RiQ4/Eric_Pina_Electiva_2025_C2/Diseños/Garabato.jpg

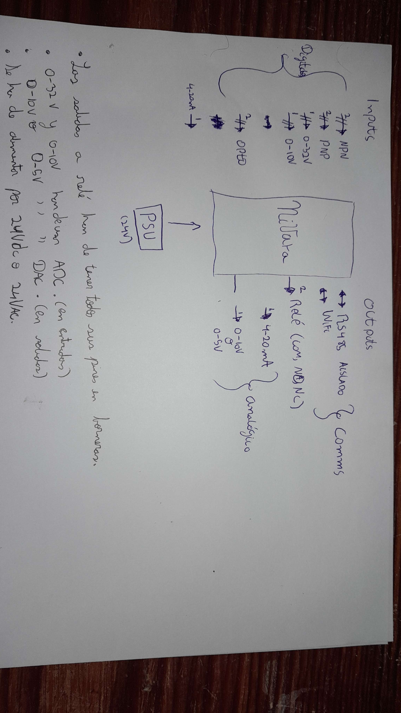
Diseños/Garabato.jpg
