RiQ4/Eric_Pina_Electiva_2025_C2/Documentos/Resumenes_Investigaciones/Eric Piña - MBSE.pdf

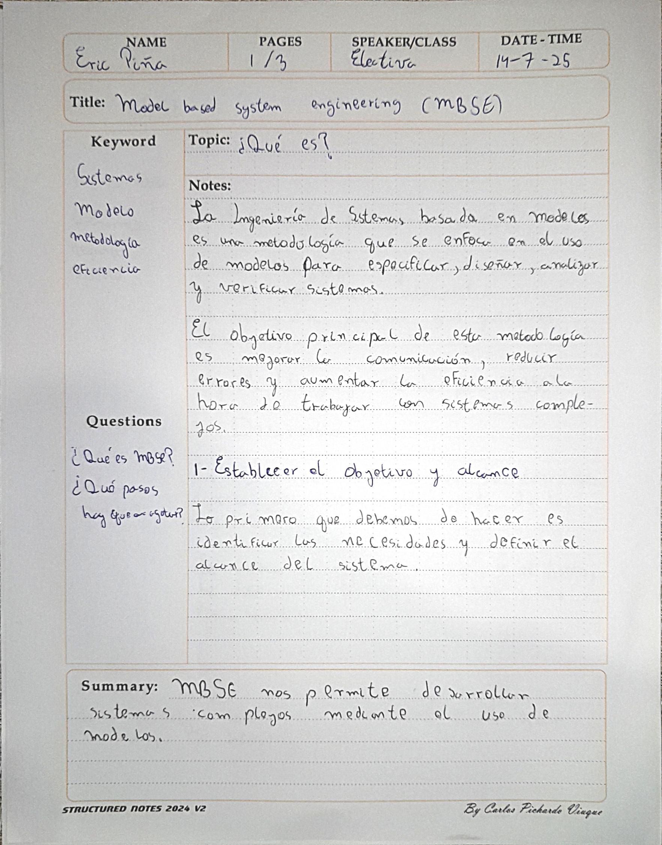
[picture p2: page 1]
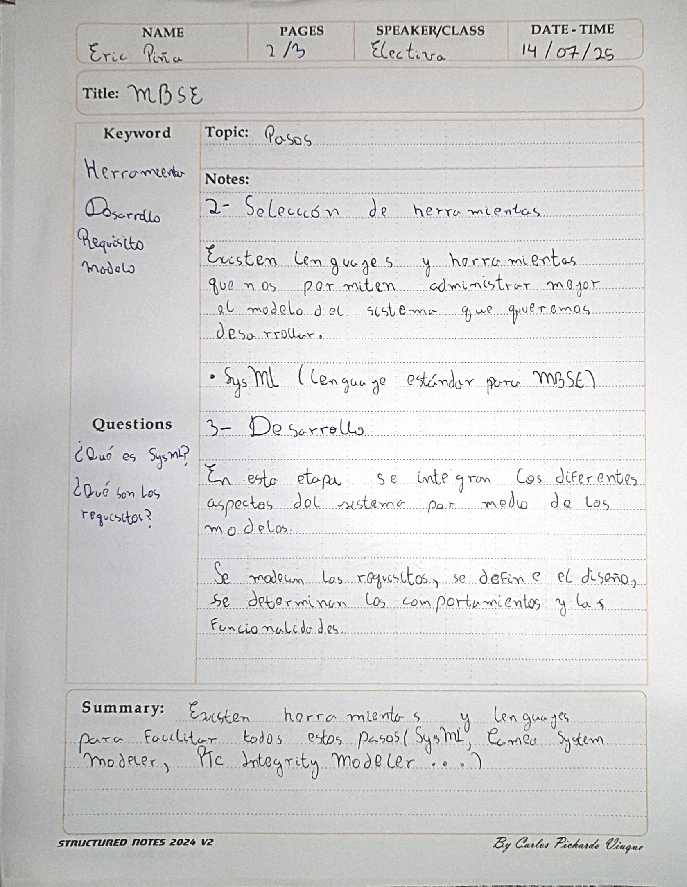
[picture p3: page 2]
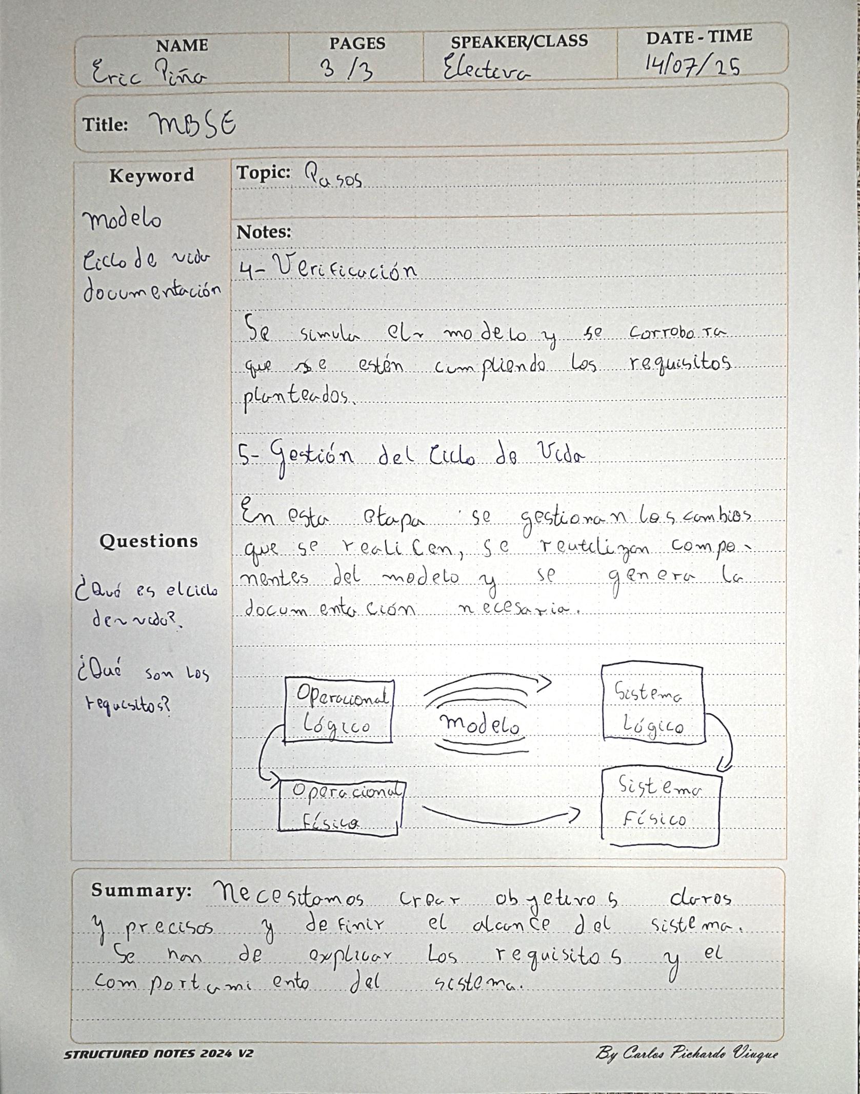
[picture p4: page 3]
