RiQ4/Eric_Pina_Electiva_2025_C2/Documentos/Resumenes_Investigaciones/Eric Piña - Lazo de Corriente.pdf

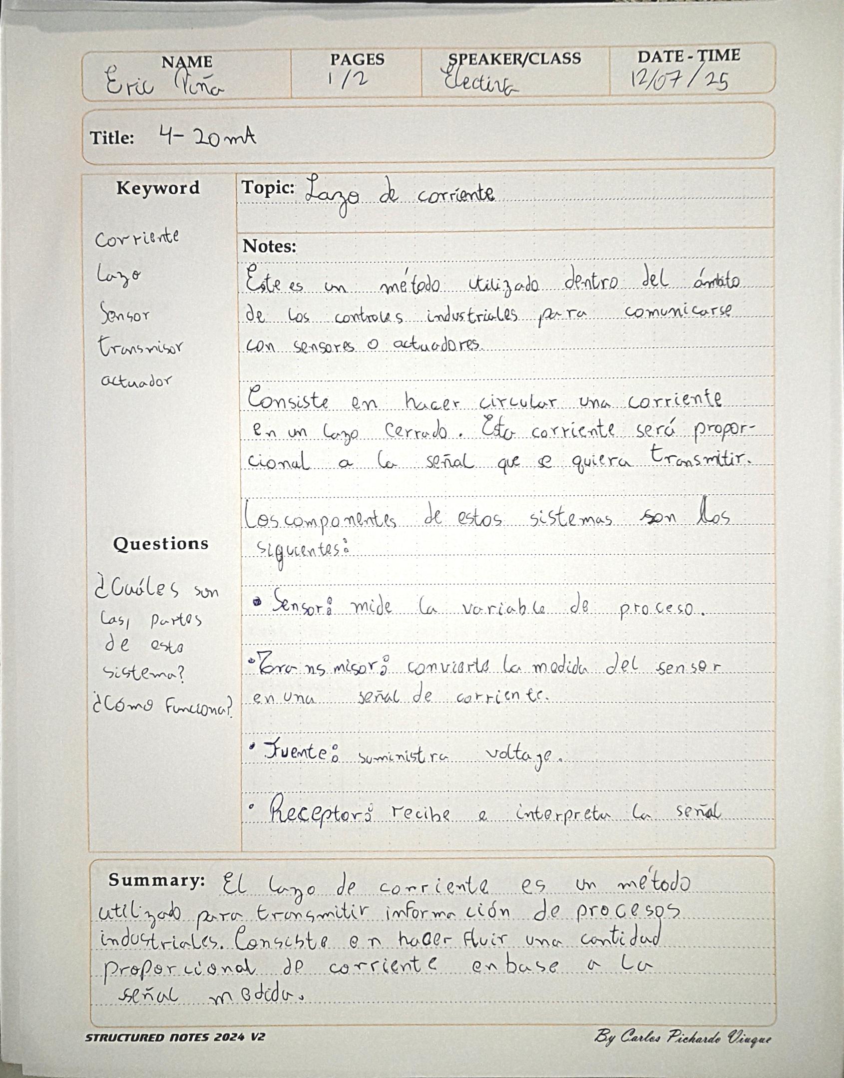
[picture p5: page 1]
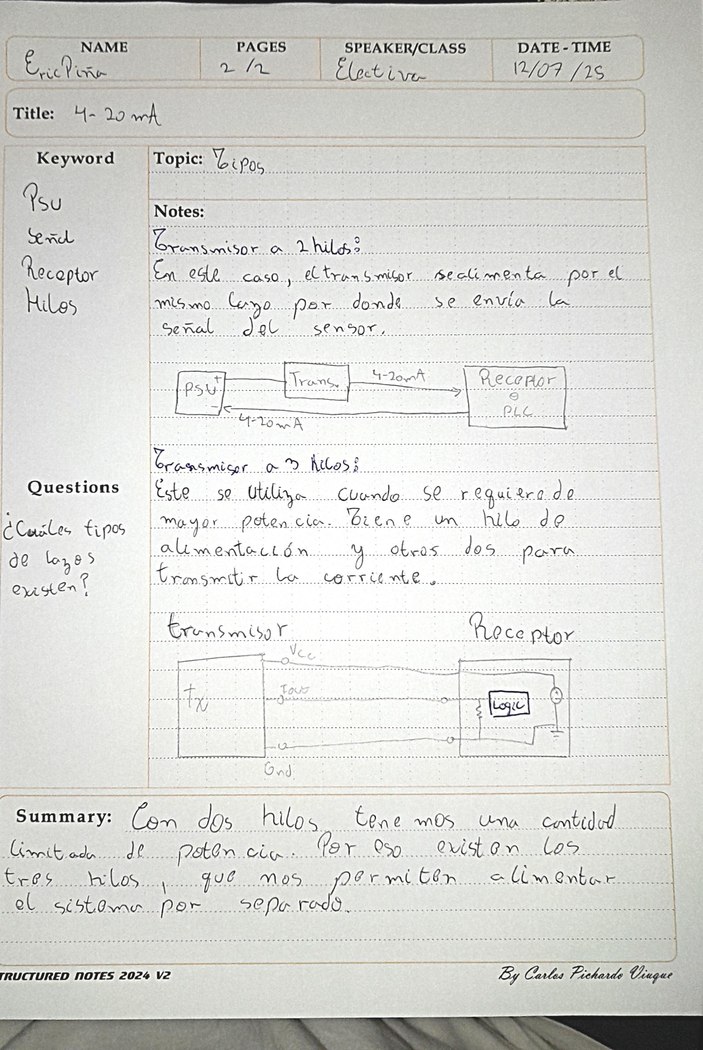
[picture p6: page 2]
