RiQ4/Eric_Pina_Electiva_2025_C2/Diseños/Piezas/FreeCAD/Tapa.FCStd

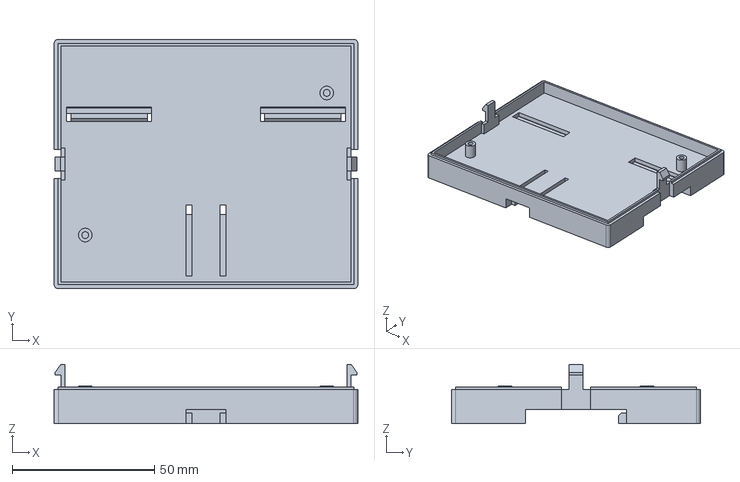
[picture p7: CAD file, 2025-06-05]
Diseños/Piezas/FreeCAD/Tapa.FCStd
107.0 x 87.7 x 20.8 mm
