RiQ4/Eric_Pina_Electiva_2025_C2/Diseños/Piezas/FreeCAD/Cuerpo.FCStd

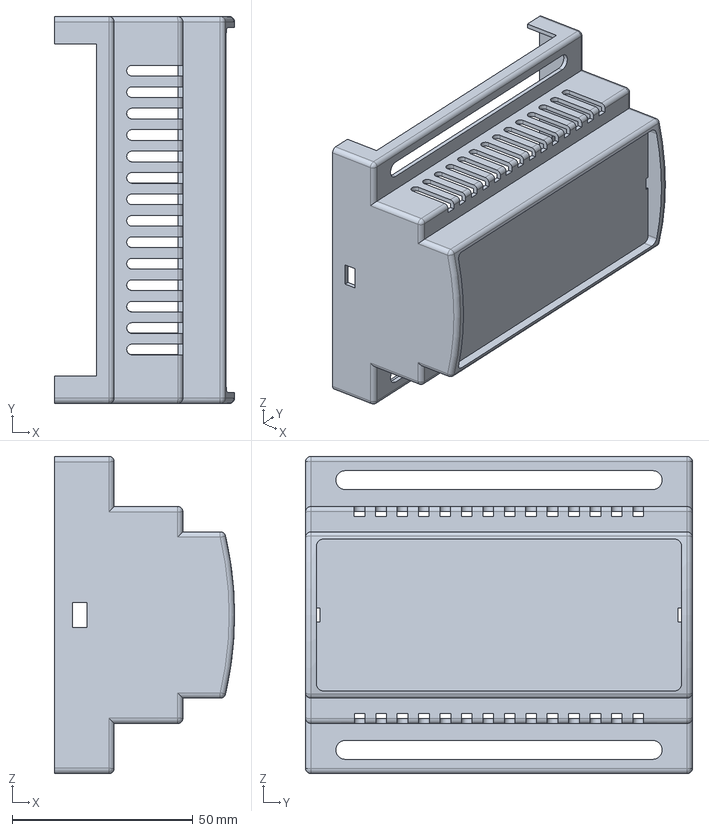
[picture p8: CAD file, 2025-06-05]
Diseños/Piezas/FreeCAD/Cuerpo.FCStd
49.8 x 107.0 x 87.7 mm
