RiQ4/Eric_Pina_Electiva_2025_C2/Kicad/NIVARA/NIVARA.kicad_pcb

## KiCad design Kicad/NIVARA/NIVARA.kicad_pcb (2025-08-22)

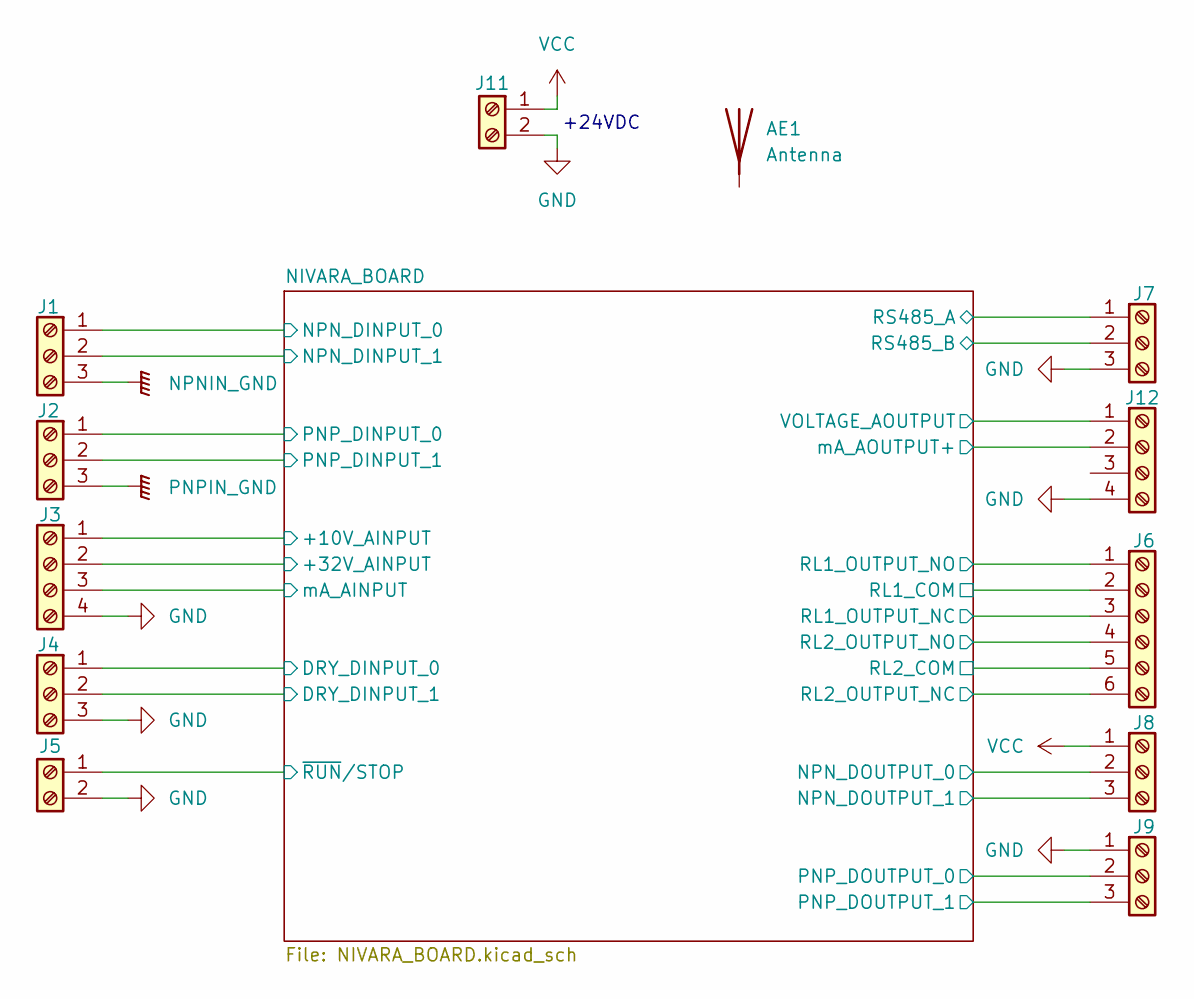
[picture p9: schematic NIVARA.kicad_sch]

Parts:
AE1: Antenna
J1, J2, J4, J7, J8, J9: Screw_Terminal_01x03; TerminalBlock_4Ucon_1x03_P3.50mm_Horizontal
J3, J12: Screw_Terminal_01x04; TerminalBlock_4Ucon_1x04_P3.50mm_Horizontal
J5, J11: Screw_Terminal_01x02; TerminalBlock_4Ucon_1x02_P3.50mm_Horizontal
J6: Screw_Terminal_01x06; TerminalBlock_4Ucon_1x06_P3.50mm_Horizontal

Connections:
/NIVARA_BOARD/+10V_AINPUT: J3.1; also elsewhere on the board
/NIVARA_BOARD/+32V_AINPUT: J3.2; also elsewhere on the board
/NIVARA_BOARD/DRY_DINPUT_0: J4.1; also elsewhere on the board
/NIVARA_BOARD/DRY_DINPUT_1: J4.2; also elsewhere on the board
/NIVARA_BOARD/NPN_DINPUT_0: J1.1; also elsewhere on the board
/NIVARA_BOARD/NPN_DINPUT_1: J1.2; also elsewhere on the board
/NIVARA_BOARD/NPN_DOUTPUT_0: J8.2; also elsewhere on the board
/NIVARA_BOARD/NPN_DOUTPUT_1: J8.3; also elsewhere on the board
/NIVARA_BOARD/PNP_DINPUT_0: J2.1; also elsewhere on the board
/NIVARA_BOARD/PNP_DINPUT_1: J2.2; also elsewhere on the board
/NIVARA_BOARD/PNP_DOUTPUT_0: J9.2; also elsewhere on the board
/NIVARA_BOARD/PNP_DOUTPUT_1: J9.3; also elsewhere on the board
/NIVARA_BOARD/RL1_COM: J6.2; also elsewhere on the board
/NIVARA_BOARD/RL1_OUTPUT_NC: J6.3; also elsewhere on the board
/NIVARA_BOARD/RL1_OUTPUT_NO: J6.1; also elsewhere on the board
/NIVARA_BOARD/RL2_COM: J6.5; also elsewhere on the board
/NIVARA_BOARD/RL2_OUTPUT_NC: J6.6; also elsewhere on the board
/NIVARA_BOARD/RL2_OUTPUT_NO: J6.4; also elsewhere on the board
/NIVARA_BOARD/RS485_A: J7.1; also elsewhere on the board
/NIVARA_BOARD/RS485_B: J7.2; also elsewhere on the board
/NIVARA_BOARD/VOLTAGE_AOUTPUT: J12.1; also elsewhere on the board
/NIVARA_BOARD/mA_AINPUT: J3.3; also elsewhere on the board
/NIVARA_BOARD/mA_AOUTPUT+: J12.2; also elsewhere on the board
/NIVARA_BOARD/~RUN/STOP: J5.1; also elsewhere on the board
GND: J3.4, J4.3, J5.2, J7.3, J9.1, J11.2, J12.4; also elsewhere on the board
NPNIN_GND: J1.3; also elsewhere on the board
PNPIN_GND: J2.3; also elsewhere on the board
VCC: J8.1, J11.1; also elsewhere on the board

Notes on the sheet:
+24VDC

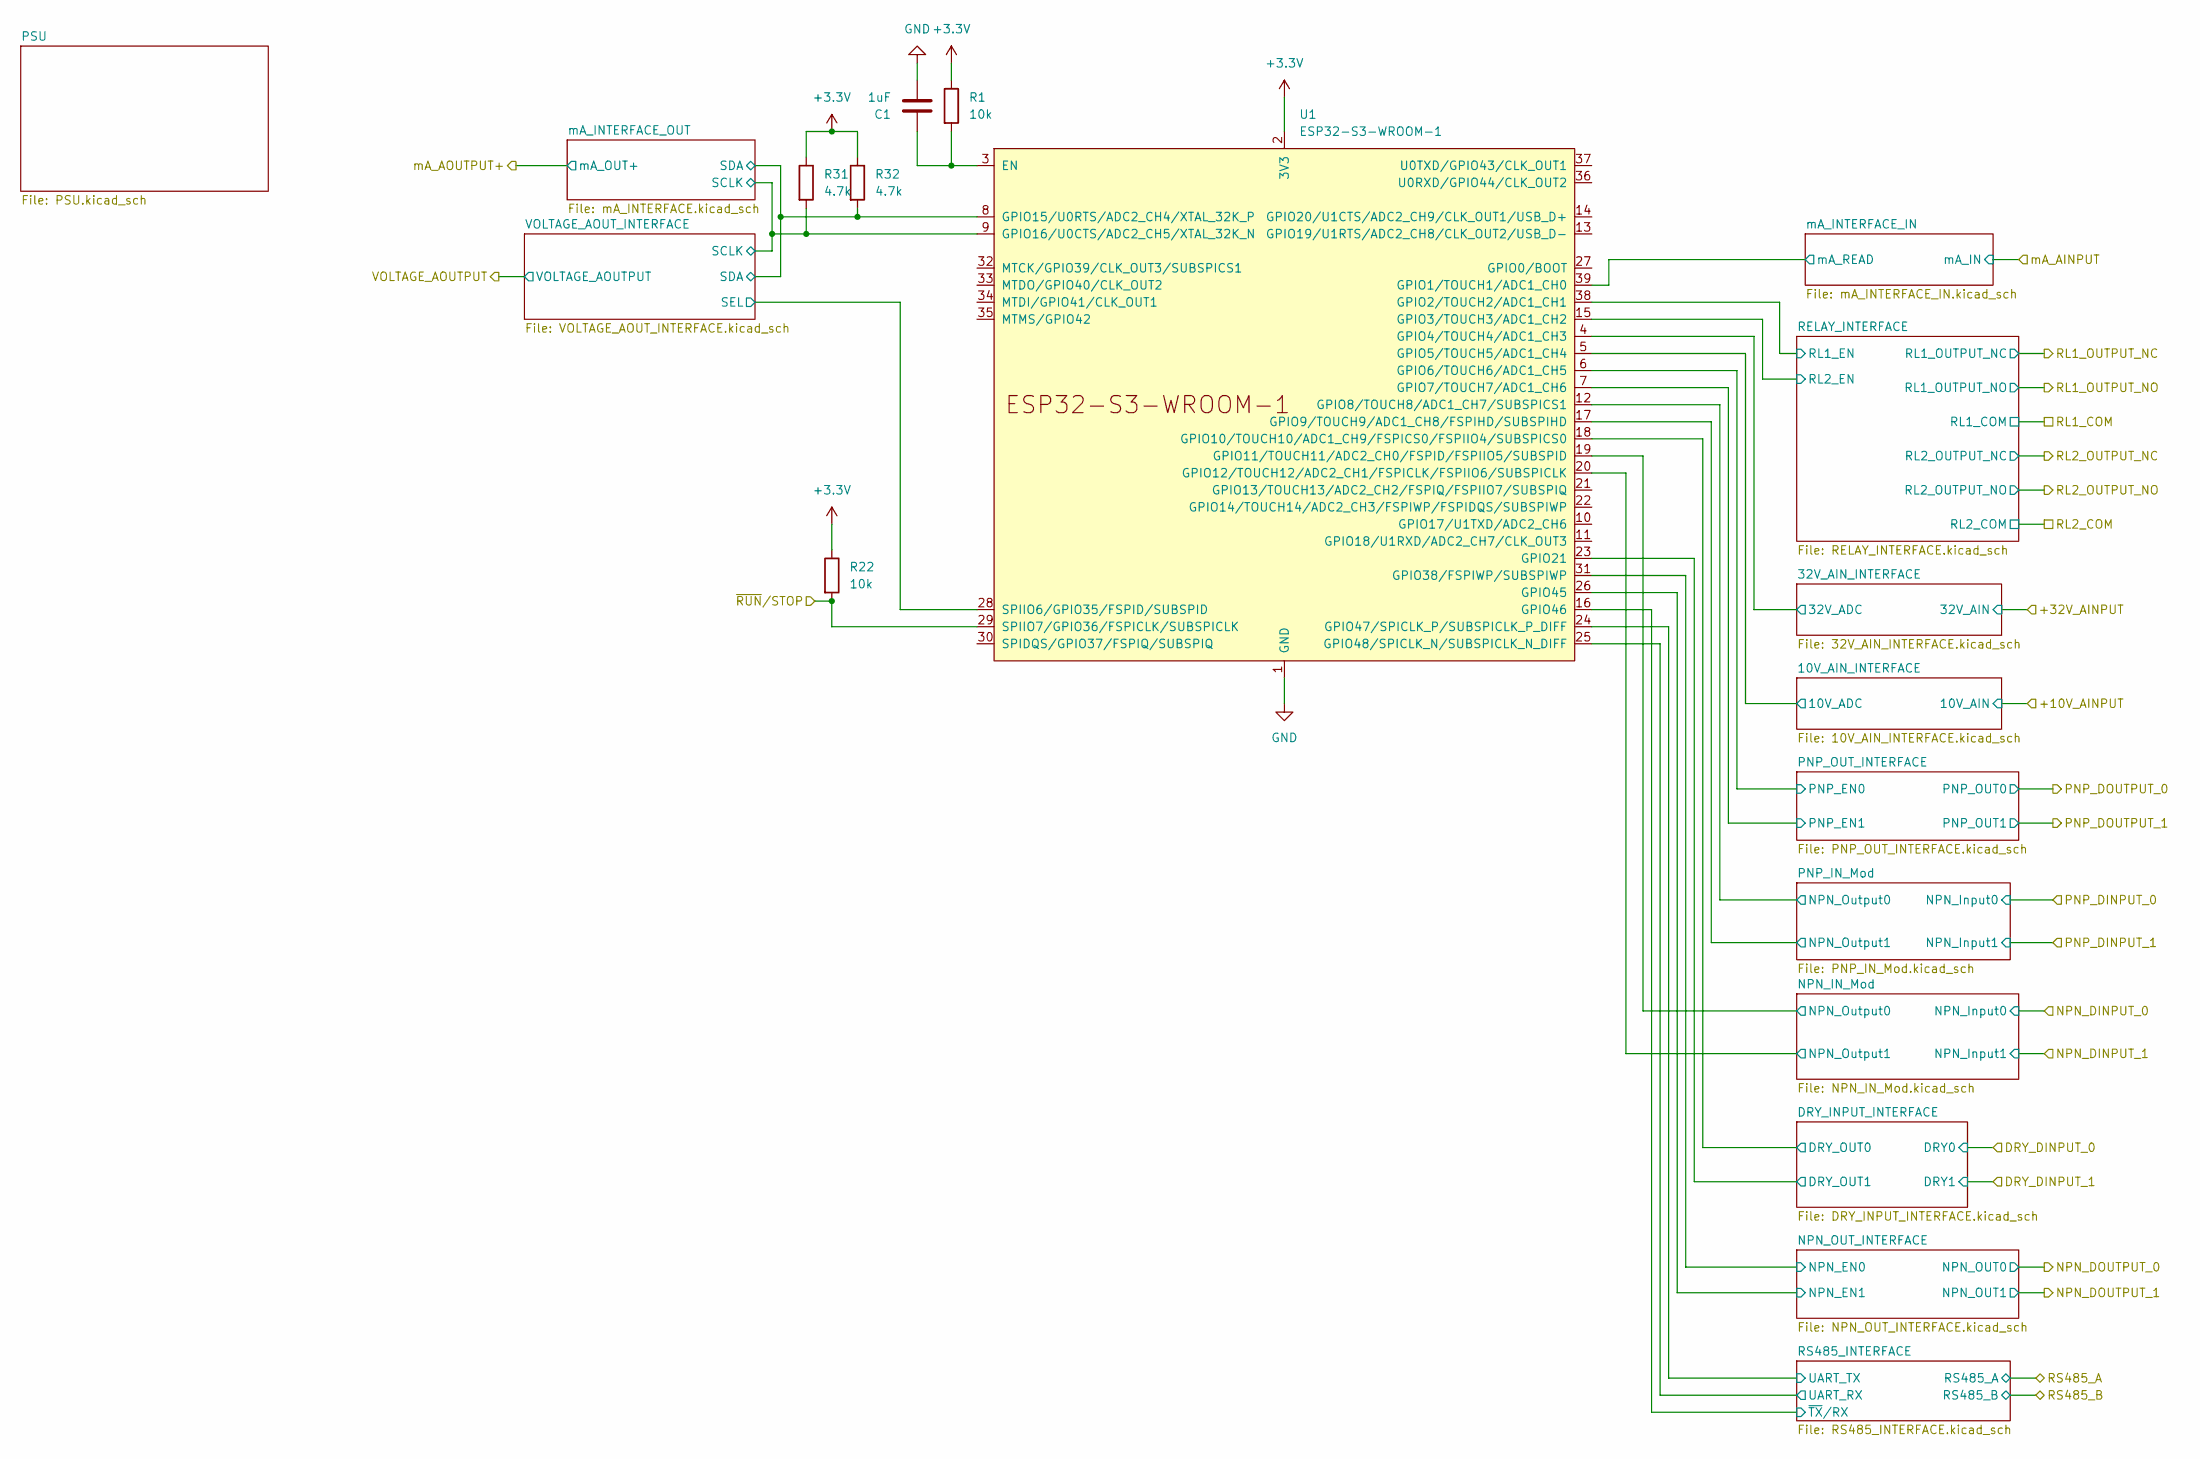
[picture p10: schematic NIVARA_BOARD.kicad_sch, NIVARA]

Parts:
C1: 1uF; C_0603_1608Metric
R1, R22: 10k; R_0603_1608Metric
R31, R32: 4.7k; R_0603_1608Metric
U1: ESP32-S3-WROOM-1

Connections:
+3.3V: R1.1, R22.1, R31.1, R32.1, U1.2 (3V3); also elsewhere on the board
/NIVARA_BOARD/10V_AIN_INTERFACE/10V_ADC: U1.5 (GPIO5/TOUCH5/ADC1_CH4); also elsewhere on the board
/NIVARA_BOARD/32V_AIN_INTERFACE/32V_ADC: U1.4 (GPIO4/TOUCH4/ADC1_CH3); also elsewhere on the board
/NIVARA_BOARD/DRY_INPUT_INTERFACE/DRY_OUT0: U1.18 (GPIO10/TOUCH10/ADC1_CH9/FSPICS0/FSPIIO4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); also elsewhere on the board
/NIVARA_BOARD/DRY_INPUT_INTERFACE/DRY_OUT1: U1.23 (GPIO21); also elsewhere on the board
/NIVARA_BOARD/NPN_IN_Mod/NPN_Output0: U1.19 (GPIO11/TOUCH11/ADC2_CH0/FSPID/FSPIIO5/S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); also elsewhere on the board
/NIVARA_BOARD/NPN_IN_Mod/NPN_Output1: U1.20 (GPIO12/TOUCH12/ADC2_CH1/FSPICLK/FSPIIO6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); also elsewhere on the board
/NIVARA_BOARD/NPN_OUT_INTERFACE/NPN_EN0: U1.31 (GPIO38/FSPIWP/SUBSPIWP); also elsewhere on the board
/NIVARA_BOARD/NPN_OUT_INTERFACE/NPN_EN1: U1.26 (GPIO45); also elsewhere on the board
/NIVARA_BOARD/PNP_IN_Mod/NPN_Output0: U1.12 (GPIO8/TOUCH8/ADC1_CH7/SUBSPICS1); also elsewhere on the board
/NIVARA_BOARD/PNP_IN_Mod/NPN_Output1: U1.17 (GPIO9/TOUCH9/ADC1_CH8/FSPIHD/SUBSPIHD); also elsewhere on the board
/NIVARA_BOARD/PNP_OUT_INTERFACE/PNP_EN0: U1.6 (GPIO6/TOUCH6/ADC1_CH5); also elsewhere on the board
/NIVARA_BOARD/PNP_OUT_INTERFACE/PNP_EN1: U1.7 (GPIO7/TOUCH7/ADC1_CH6); also elsewhere on the board
/NIVARA_BOARD/RELAY_INTERFACE/RL1_EN: U1.38 (GPIO2/TOUCH2/ADC1_CH1); also elsewhere on the board
/NIVARA_BOARD/RELAY_INTERFACE/RL2_EN: U1.15 (GPIO3/TOUCH3/ADC1_CH2); also elsewhere on the board
/NIVARA_BOARD/RS485_INTERFACE/UART_RX: U1.25 (GPIO48/SPICLK_N/SUBSPICLK_N_DIFF); also elsewhere on the board
/NIVARA_BOARD/RS485_INTERFACE/UART_TX: U1.24 (GPIO47/SPICLK_P/SUBSPICLK_P_DIFF); also elsewhere on the board
/NIVARA_BOARD/RS485_INTERFACE/~TX/RX: U1.16 (GPIO46); also elsewhere on the board
/NIVARA_BOARD/VOLTAGE_AOUT_INTERFACE/SCLK: R31.2, U1.9 (GPIO16/U0CTS/ADC2_CH5/XTAL_32K_N); also elsewhere on the board
/NIVARA_BOARD/VOLTAGE_AOUT_INTERFACE/SDA: R32.2, U1.8 (GPIO15/U0RTS/ADC2_CH4/XTAL_32K_P); also elsewhere on the board
/NIVARA_BOARD/VOLTAGE_AOUT_INTERFACE/SEL: U1.28 (SPIIO6/GPIO35/FSPID/SUBSPID); also elsewhere on the board
/NIVARA_BOARD/mA_AINPUT: U1.39 (GPIO1/TOUCH1/ADC1_CH0); also elsewhere on the board
/NIVARA_BOARD/~RUN/STOP: R22.2, U1.29 (SPIIO7/GPIO36/FSPICLK/SUBSPICLK); also elsewhere on the board
GND: C1.2, U1.1 (GND), U1.40 (GND), U1.41 (GND); also elsewhere on the board
unnamed: C1.1, R1.2, U1.3 (EN)

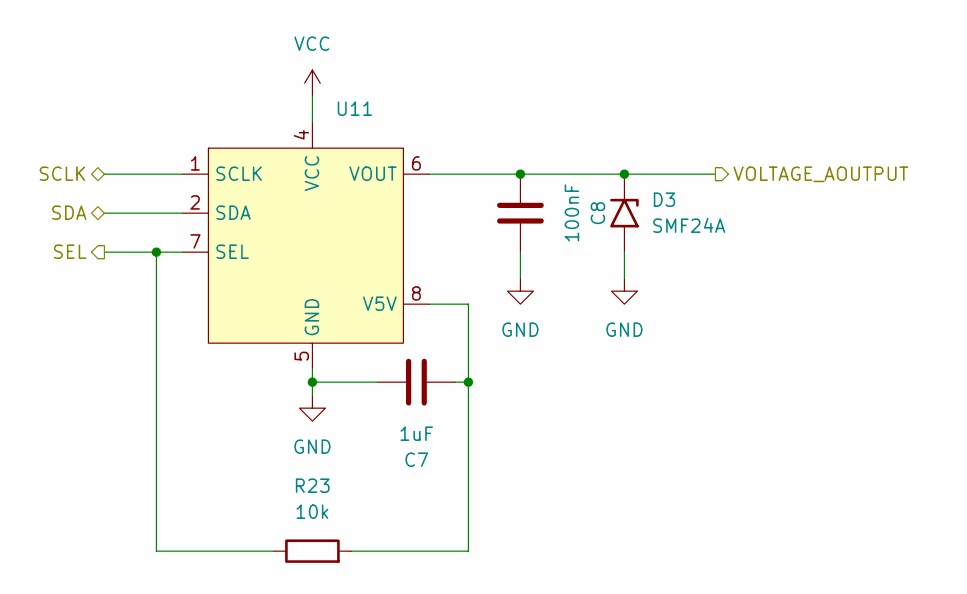
[picture p11: schematic VOLTAGE_AOUT_INTERFACE.kicad_sch]

Parts:
C7: 1uF; C_0603_1608Metric
C8: 100nF; C_0603_1608Metric
D3: SMF24A; D_SMF; LCSC# C7495269
R23: 10k; R_0603_1608Metric
U11: eSOP-8

Connections:
/NIVARA_BOARD/VOLTAGE_AOUTPUT: C8.2, D3.1 (A1), U11.6 (VOUT); also elsewhere on the board
/NIVARA_BOARD/VOLTAGE_AOUT_INTERFACE/SCLK: U11.1 (SCLK); also elsewhere on the board
/NIVARA_BOARD/VOLTAGE_AOUT_INTERFACE/SDA: U11.2 (SDA); also elsewhere on the board
/NIVARA_BOARD/VOLTAGE_AOUT_INTERFACE/SEL: R23.1, U11.7 (SEL); also elsewhere on the board
GND: C7.1, C8.1, D3.2 (A2), U11.5 (GND); also elsewhere on the board
unnamed: C7.2, R23.2, U11.8 (V5V)
VCC: U11.4 (VCC); also elsewhere on the board

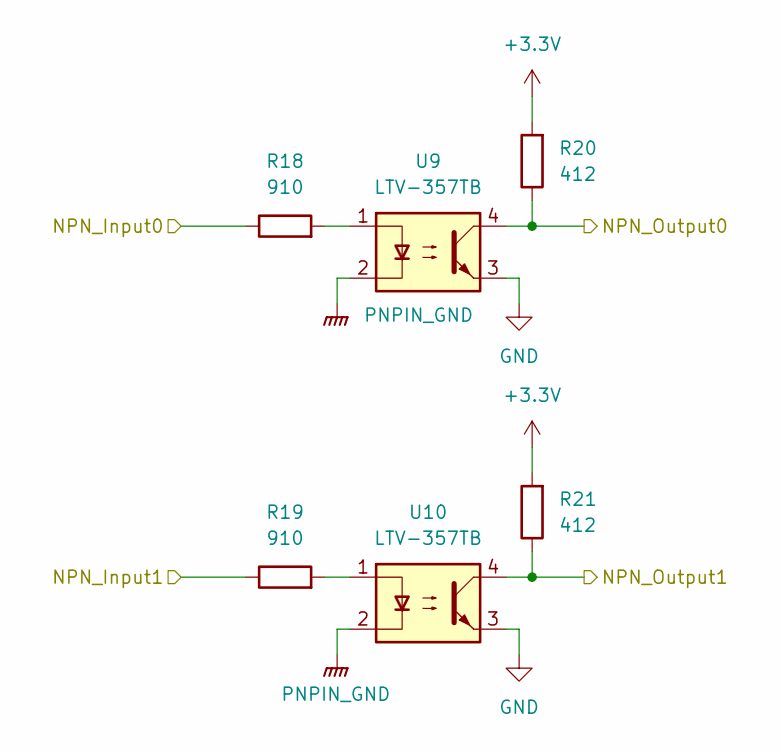
[picture p12: schematic PNP_IN_Mod.kicad_sch]

Parts:
R18, R19: 910; R_0603_1608Metric; LCSC# C114670
R20, R21: 412; R_0603_1608Metric
U9, U10: LTV-357TB; SO-4_4.4x3.6mm_P2.54mm

Connections:
+3.3V: R20.2, R21.2; also elsewhere on the board
/NIVARA_BOARD/PNP_DINPUT_0: R18.1; also elsewhere on the board
/NIVARA_BOARD/PNP_DINPUT_1: R19.1; also elsewhere on the board
/NIVARA_BOARD/PNP_IN_Mod/NPN_Output0: R20.1, U9.4; also elsewhere on the board
/NIVARA_BOARD/PNP_IN_Mod/NPN_Output1: R21.1, U10.4; also elsewhere on the board
GND: U9.3, U10.3; also elsewhere on the board
unnamed: R18.2, U9.1
unnamed: R19.2, U10.1
PNPIN_GND: U9.2, U10.2; also elsewhere on the board

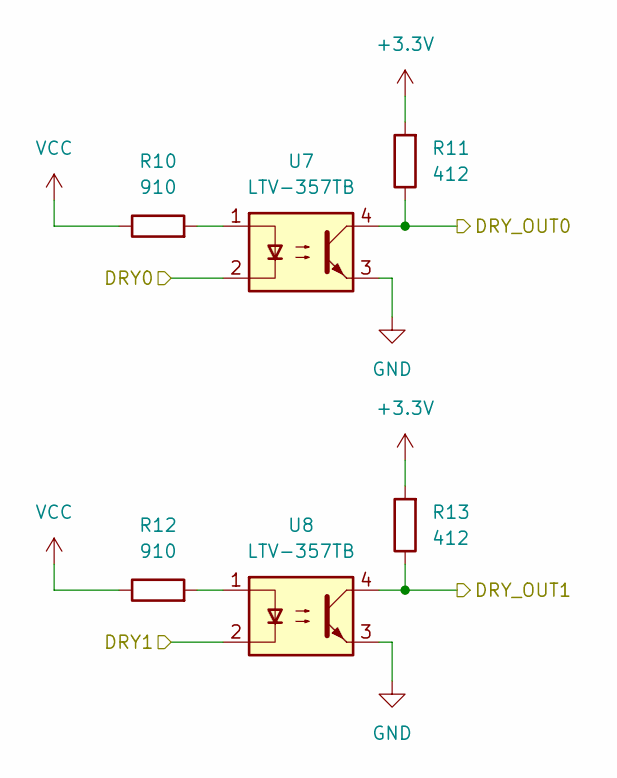
[picture p13: schematic DRY_INPUT_INTERFACE.kicad_sch]

Parts:
R10, R12: 910; R_0603_1608Metric; LCSC# C114670
R11, R13: 412; R_0603_1608Metric
U7, U8: LTV-357TB; SO-4_4.4x3.6mm_P2.54mm

Connections:
+3.3V: R11.2, R13.2; also elsewhere on the board
/NIVARA_BOARD/DRY_DINPUT_0: U7.2; also elsewhere on the board
/NIVARA_BOARD/DRY_DINPUT_1: U8.2; also elsewhere on the board
/NIVARA_BOARD/DRY_INPUT_INTERFACE/DRY_OUT0: R11.1, U7.4; also elsewhere on the board
/NIVARA_BOARD/DRY_INPUT_INTERFACE/DRY_OUT1: R13.1, U8.4; also elsewhere on the board
GND: U7.3, U8.3; also elsewhere on the board
unnamed: R10.2, U7.1
unnamed: R12.2, U8.1
VCC: R10.1, R12.1; also elsewhere on the board

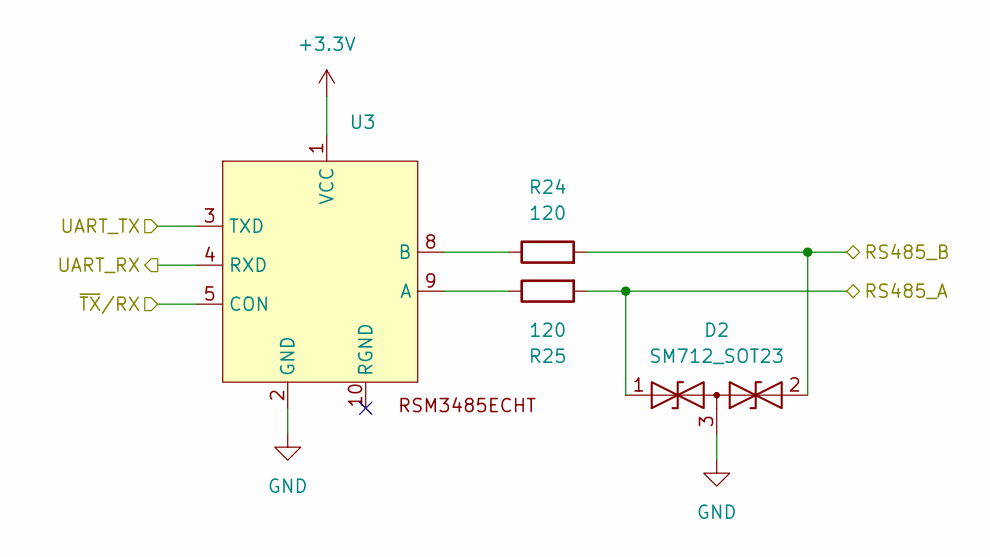
[picture p14: schematic RS485_INTERFACE.kicad_sch]

Parts:
D2: SM712_SOT23; SOT-23
R24, R25: 120; R_0603_1608Metric
U3: YLPTEC RSM3485ECHT

Connections:
+3.3V: U3.1 (VCC); also elsewhere on the board
/NIVARA_BOARD/RS485_A: D2.1 (A1), R25.2; also elsewhere on the board
/NIVARA_BOARD/RS485_B: D2.2 (A2), R24.2; also elsewhere on the board
/NIVARA_BOARD/RS485_INTERFACE/UART_RX: U3.4 (RXD); also elsewhere on the board
/NIVARA_BOARD/RS485_INTERFACE/UART_TX: U3.3 (TXD); also elsewhere on the board
/NIVARA_BOARD/RS485_INTERFACE/~TX/RX: U3.5 (CON); also elsewhere on the board
GND: D2.3 (common), U3.2 (GND); also elsewhere on the board
unnamed: R25.1, U3.9 (A)
unnamed: R24.1, U3.8 (B)

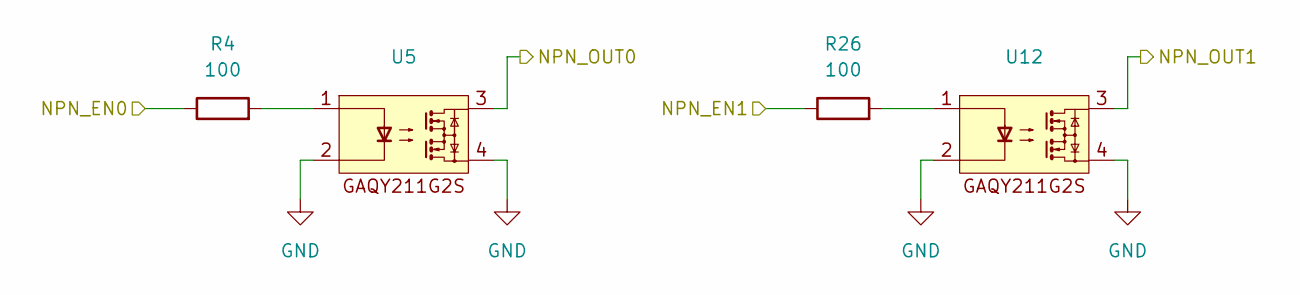
[picture p15: schematic NPN_OUT_INTERFACE.kicad_sch]

Parts:
R4, R26: 100; R_0603_1608Metric
U5, U12: SO-4_4.4x4.3mm_P2.54mm

Connections:
/NIVARA_BOARD/NPN_DOUTPUT_0: U5.3; also elsewhere on the board
/NIVARA_BOARD/NPN_DOUTPUT_1: U12.3; also elsewhere on the board
/NIVARA_BOARD/NPN_OUT_INTERFACE/NPN_EN0: R4.1; also elsewhere on the board
/NIVARA_BOARD/NPN_OUT_INTERFACE/NPN_EN1: R26.1; also elsewhere on the board
GND: U5.2, U5.4, U12.2, U12.4; also elsewhere on the board
unnamed: R4.2, U5.1
unnamed: R26.2, U12.1

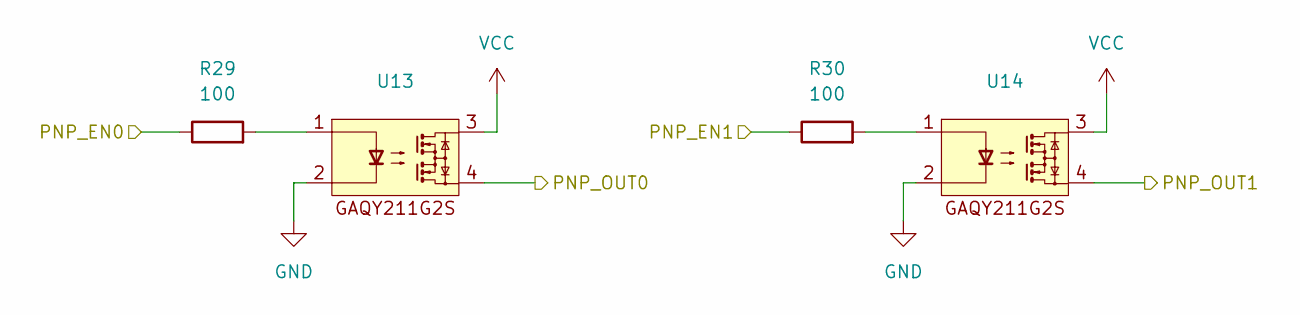
[picture p16: schematic PNP_OUT_INTERFACE.kicad_sch]

Parts:
R29, R30: 100; R_0603_1608Metric
U13, U14: SO-4_4.4x4.3mm_P2.54mm

Connections:
/NIVARA_BOARD/PNP_DOUTPUT_0: U13.4; also elsewhere on the board
/NIVARA_BOARD/PNP_DOUTPUT_1: U14.4; also elsewhere on the board
/NIVARA_BOARD/PNP_OUT_INTERFACE/PNP_EN0: R29.1; also elsewhere on the board
/NIVARA_BOARD/PNP_OUT_INTERFACE/PNP_EN1: R30.1; also elsewhere on the board
GND: U13.2, U14.2; also elsewhere on the board
unnamed: R29.2, U13.1
unnamed: R30.2, U14.1
VCC: U13.3, U14.3; also elsewhere on the board

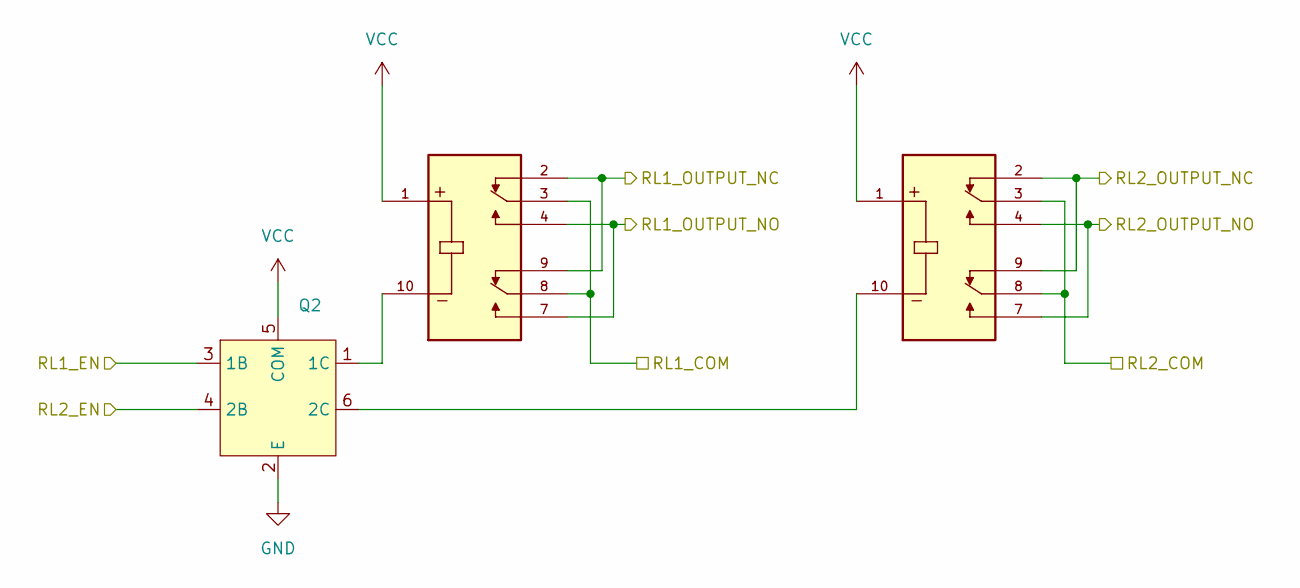
[picture p17: schematic RELAY_INTERFACE.kicad_sch]

Parts:
K1, K2: TQ2-24V; TQ2=24V; PARTREV 201911
Q2: SOT-363_SC-70-6; LCSC# C2984831

Connections:
/NIVARA_BOARD/RELAY_INTERFACE/RL1_EN: Q2.3 (1B); also elsewhere on the board
/NIVARA_BOARD/RELAY_INTERFACE/RL2_EN: Q2.4 (2B); also elsewhere on the board
/NIVARA_BOARD/RL1_COM: K1.3, K1.8; also elsewhere on the board
/NIVARA_BOARD/RL1_OUTPUT_NC: K1.2, K1.9; also elsewhere on the board
/NIVARA_BOARD/RL1_OUTPUT_NO: K1.4, K1.7; also elsewhere on the board
/NIVARA_BOARD/RL2_COM: K2.3, K2.8; also elsewhere on the board
/NIVARA_BOARD/RL2_OUTPUT_NC: K2.2, K2.9; also elsewhere on the board
/NIVARA_BOARD/RL2_OUTPUT_NO: K2.4, K2.7; also elsewhere on the board
GND: Q2.2 (E); also elsewhere on the board
unnamed: K1.10, Q2.1 (1C)
unnamed: K2.10, Q2.6 (2C)
VCC: K1.1, K2.1, Q2.5 (COM); also elsewhere on the board

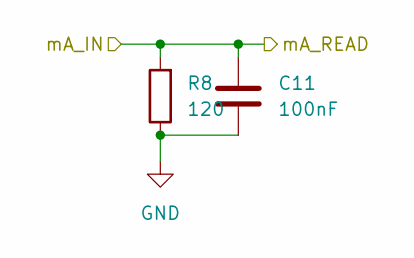
[picture p18: schematic mA_INTERFACE_IN.kicad_sch]

Parts:
C11: 100nF; C_0603_1608Metric
R8: 120; R_0603_1608Metric; Tolerance 0.1-1%

Connections:
/NIVARA_BOARD/mA_AINPUT: C11.1, R8.2; also elsewhere on the board
GND: C11.2, R8.1; also elsewhere on the board

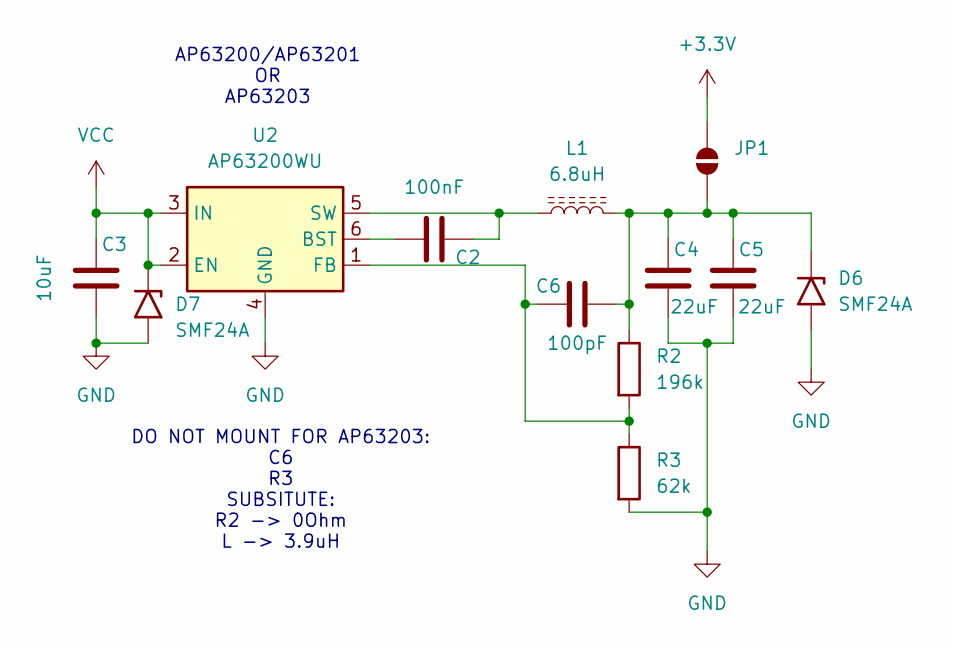
[picture p19: schematic PSU.kicad_sch]

Parts:
C2: 100nF; C_0603_1608Metric
C3: 10uF; C_0603_1608Metric; Voltage 50V
C4, C5: 22uF; C_0603_1608Metric
C6: 100pF; C_0603_1608Metric
D6, D7: SMF24A; D_SMF
JP1: SolderJumper_2_Open; SolderJumper-2_P1.3mm_Open_RoundedPad1.0x1.5mm
L1: 6.8uH; L_6.3x6.3_H3
R2: 196k; R_0603_1608Metric
R3: 62k; R_0603_1608Metric
U2: AP63200WU; TSOT-23-6

Connections:
+3.3V: JP1.2 (B); also elsewhere on the board
GND: C3.1, C4.1, C5.1, D6.2 (A2), D7.2 (A2), R3.2, U2.4 (GND); also elsewhere on the board
unnamed: C4.2, C5.2, C6.1, D6.1 (A1), JP1.1 (A), L1.2, R2.1
unnamed: C2.1, U2.6 (BST)
unnamed: C6.2, R2.2, R3.1, U2.1 (FB)
unnamed: C2.2, L1.1, U2.5 (SW)
VCC: C3.2, D7.1 (A1), U2.2 (EN), U2.3 (IN); also elsewhere on the board

Notes on the sheet:
DO NOT MOUNT FOR AP63203: C6 R3 SUBSITUTE: R2 -> 0Ohm L -> 3.9uH
AP63200/AP63201 OR AP63203

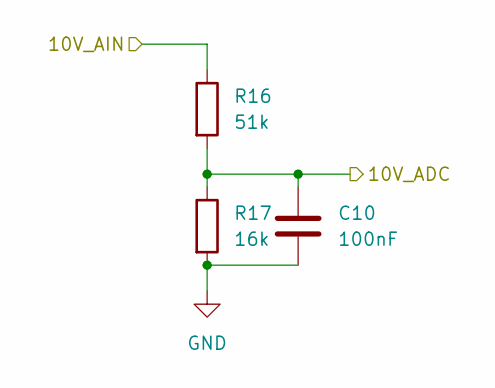
[picture p20: schematic 10V_AIN_INTERFACE.kicad_sch]

Parts:
C10: 100nF; C_0603_1608Metric
R16: 51k; R_0603_1608Metric
R17: 16k; R_0603_1608Metric

Connections:
/NIVARA_BOARD/10V_AIN_INTERFACE/10V_ADC: C10.1, R16.2, R17.1; also elsewhere on the board
/NIVARA_BOARD/+10V_AINPUT: R16.1; also elsewhere on the board
GND: C10.2, R17.2; also elsewhere on the board

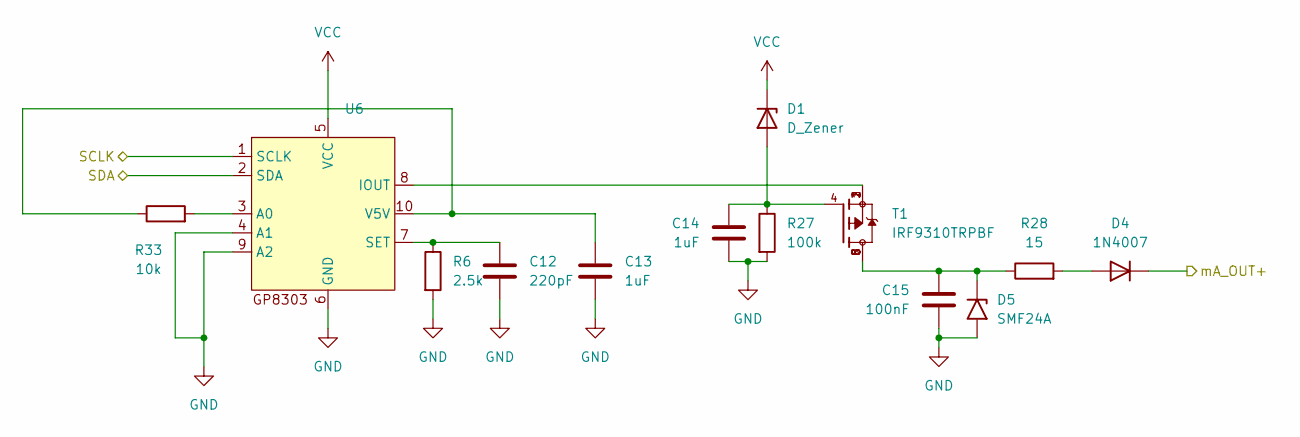
[picture p21: schematic mA_INTERFACE.kicad_sch]

Parts:
C12: 220pF; C_0603_1608Metric
C13, C14: 1uF; C_0603_1608Metric
C15: 100nF; C_0603_1608Metric
D1: D_Zener; D_SOD-123
D4: 1N4007; D_SOD-123
D5: SMF24A; D_SMF
R6: 2.5k; R_0603_1608Metric
R27: 100k; R_0603_1608Metric
R28: 15; R_0603_1608Metric
R33: 10k; R_0603_1608Metric
T1: IRF9310TRPBF; SO-8
U6: SSOP-10-1EP_3.9x4.9mm_P1mm_EP2.1x3.3mm

Connections:
/NIVARA_BOARD/VOLTAGE_AOUT_INTERFACE/SCLK: U6.1 (SCLK); also elsewhere on the board
/NIVARA_BOARD/VOLTAGE_AOUT_INTERFACE/SDA: U6.2 (SDA); also elsewhere on the board
/NIVARA_BOARD/mA_AOUTPUT+: D4.1 (K); also elsewhere on the board
GND: C12.2, C13.2, C14.2, C15.2, D5.2 (A2), R6.2, R27.2, U6.4 (A1), U6.6 (GND), U6.9 (A2); also elsewhere on the board
unnamed: C14.1, D1.2 (A), R27.1, T1.4
unnamed: D4.2 (A), R28.2
unnamed: C15.1, D5.1 (A1), R28.1, T1.5, T1.6, T1.7, T1.8
unnamed: R33.2, U6.3 (A0)
unnamed: T1.1, T1.2, T1.3, U6.8 (IOUT)
unnamed: C12.1, R6.1, U6.7 (SET)
unnamed: C13.1, R33.1, U6.10 (V5V)
VCC: D1.1 (K), U6.5 (VCC); also elsewhere on the board

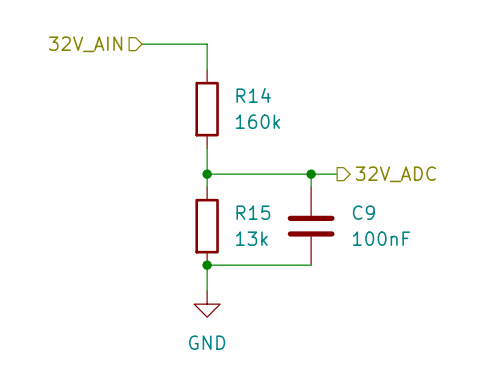
[picture p22: schematic 32V_AIN_INTERFACE.kicad_sch]

Parts:
C9: 100nF; C_0603_1608Metric
R14: 160k; R_0603_1608Metric
R15: 13k; R_0603_1608Metric

Connections:
/NIVARA_BOARD/32V_AIN_INTERFACE/32V_ADC: C9.1, R14.2, R15.1; also elsewhere on the board
/NIVARA_BOARD/+32V_AINPUT: R14.1; also elsewhere on the board
GND: C9.2, R15.2; also elsewhere on the board

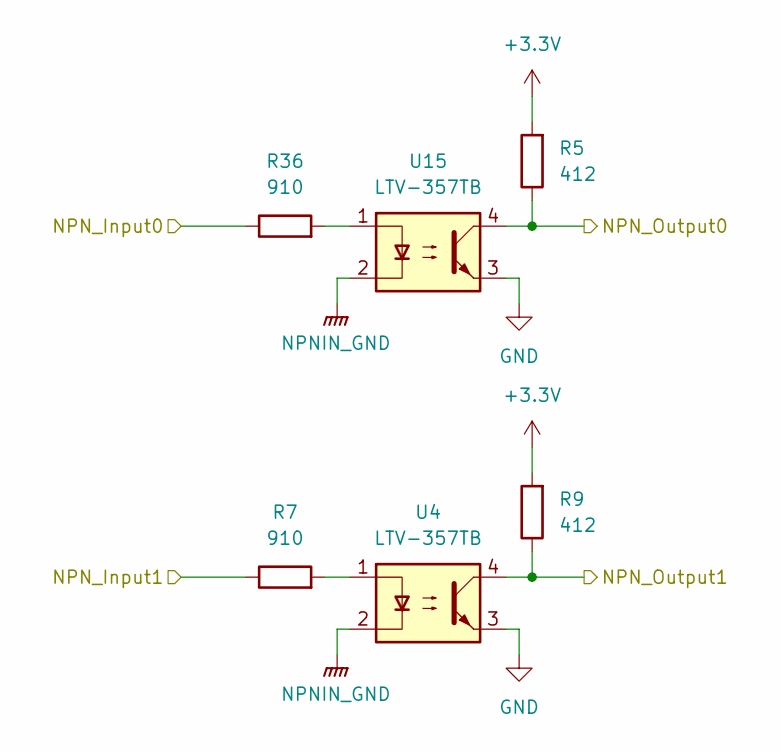
[picture p23: schematic NPN_IN_Mod.kicad_sch]

Parts:
R5, R9: 412; R_0603_1608Metric
R7, R36: 910; R_0603_1608Metric; LCSC# C114670
U4, U15: LTV-357TB; SO-4_4.4x3.6mm_P2.54mm

Connections:
+3.3V: R5.2, R9.2; also elsewhere on the board
/NIVARA_BOARD/NPN_DINPUT_0: R36.1; also elsewhere on the board
/NIVARA_BOARD/NPN_DINPUT_1: R7.1; also elsewhere on the board
/NIVARA_BOARD/NPN_IN_Mod/NPN_Output0: R5.1, U15.4; also elsewhere on the board
/NIVARA_BOARD/NPN_IN_Mod/NPN_Output1: R9.1, U4.4; also elsewhere on the board
GND: U4.3, U15.3; also elsewhere on the board
NPNIN_GND: U4.2, U15.2; also elsewhere on the board
unnamed: R7.2, U4.1
unnamed: R36.2, U15.1

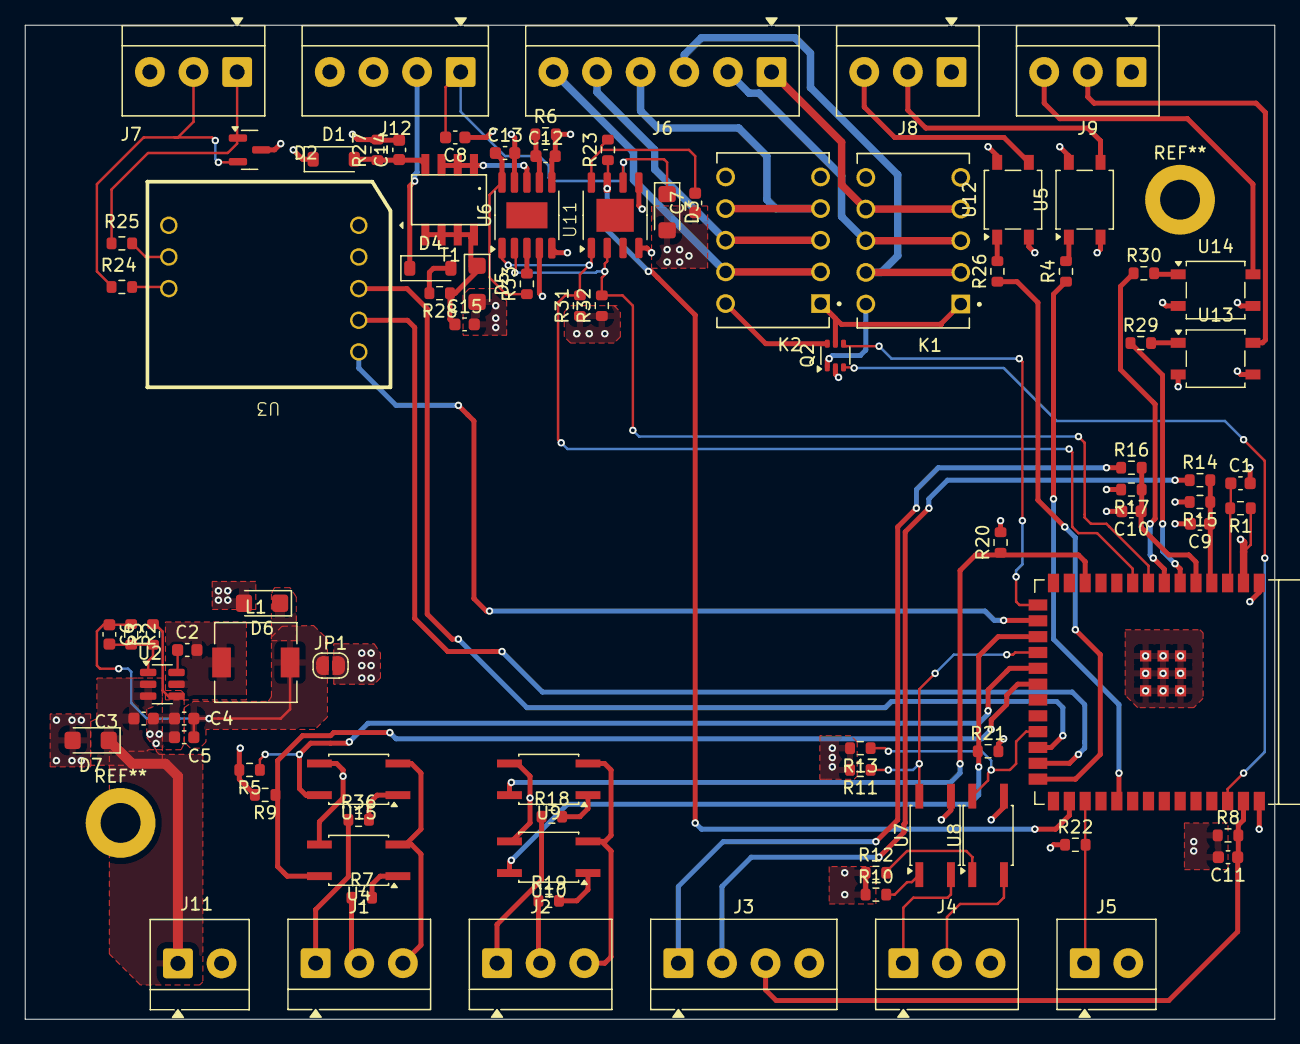
[picture p24: board NIVARA.kicad_pcb from above]

Board: 4 copper layers, 100.2 x 79.8 mm, 88 parts (0 on the bottom side), 76 nets.
