RiQ4/Eric_Pina_Electiva_2025_C2/(commit log)

2025-06-05 Diseños en programas CAD
    [Cuerpo.FCStd, Tapa.FCStd]
2025-06-13 KiCAD Files
    Creación del Proyecto en KiCAD
    [NIVARA.kicad_pcb, NIVARA.kicad_sch]
2025-06-13 Hierarchical Design In KiCAD
    [NIVARA.kicad_sch, NIVARA_BOARD.kicad_sch, PSU.kicad_sch]
2025-06-13 Hierarchical Labels added
    [NIVARA_BOARD.kicad_sch, PSU.kicad_sch]
2025-06-14 Initial Capture Finished
    [NIVARA.kicad_sch, NIVARA_BOARD.kicad_sch, PSU.kicad_sch]
2025-06-14 Wrapping up for today :3
    [NIVARA.kicad_sch, NIVARA_BOARD.kicad_sch, PSU.kicad_sch, RS485_INTERFACE.kicad_sch]
2025-06-17 Solder Jumper
    Para que no me pase lo mismo de mi proyecto
    [NIVARA.kicad_sch, PSU.kicad_sch]
2025-06-21 RS-485 Update
    RS-485 Isolated circuit updated. Created new symbol and footprint for the YLPTEC RSM3485ECHT IC.
    [NIVARA_BOARD.kicad_sch, RS485_INTERFACE.kicad_sch]
2025-06-22 Silly little things
    [RS485_INTERFACE.kicad_sch]
2025-06-23 Relay Interface
    Progress made with the Relay Interface.
    [NIVARA.kicad_pcb, NIVARA_BOARD.kicad_sch, RELAY_INTERFACE.kicad_sch]
2025-06-23 Silly little things
    Rookie mistake
    [NIVARA_BOARD.kicad_sch, RELAY_INTERFACE.kicad_sch]
2025-07-13 Documento de Requisitos
2025-07-13 Create Eric Piña - Lazo de Corriente.pdf
2025-07-16 FULL SCHEMATIC!!111!!!
    Dik
    [NIVARA.kicad_sch, NIVARA_BOARD.kicad_sch, NPN_OUT_INTERFACE.kicad_sch, PNP_IN_Mod.kicad_sch, PNP_OUT_INTERFACE.kicad_sch, PSU.kicad_sch, mA_INTERFACE.kicad_sch]
2025-07-16 tengo sueño
    Hay que dormir
    [NIVARA.kicad_pcb, NPN_IN_Mod.kicad_sch]
2025-08-15 Debí de enrutar antes :C
    tengo sueño
    [10V_AIN_INTERFACE.kicad_sch, 32V_AIN_INTERFACE.kicad_sch, DRY_INPUT_INTERFACE.kicad_sch, NIVARA.kicad_pcb, NIVARA.kicad_sch, NPN_IN_Mod.kicad_sch, NPN_OUT_INTERFACE.kicad_sch, PNP_IN_Mod.kicad_sch]
2025-08-22 Faltan dos Cositas
    Casi terminamos de enrutar
    [NIVARA.kicad_pcb, NIVARA.kicad_sch, NIVARA_BOARD.kicad_sch, RELAY_INTERFACE.kicad_sch]
2025-08-22 casi terminamos de enrutar
